liongma/Inverter/Images/20251108220109-IR.jpg

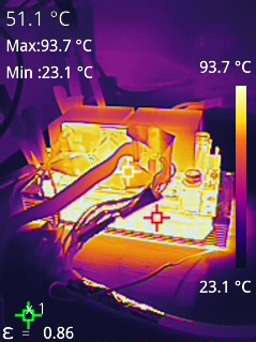
Images/20251108220109-IR.jpg
