liongma/Inverter/Images/banana.jpg

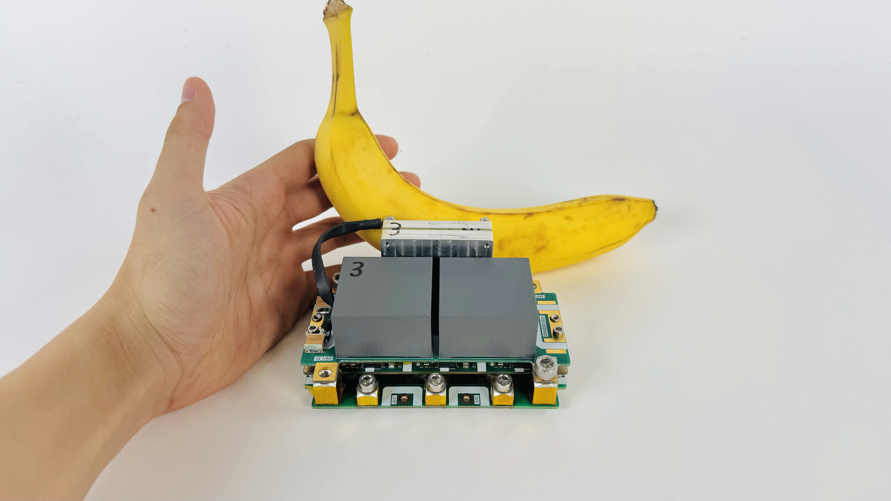
Images/banana.jpg
