liongma/Inverter/Images/box.jpg

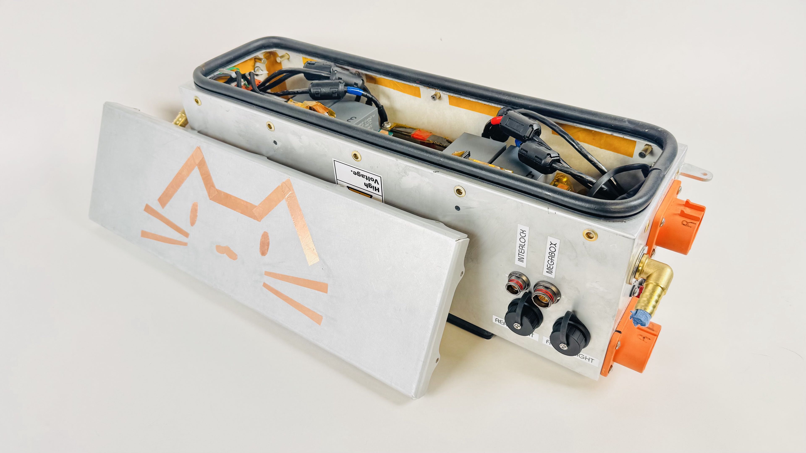
Images/box.jpg
