liongma/Inverter/Images/comparison.jpg

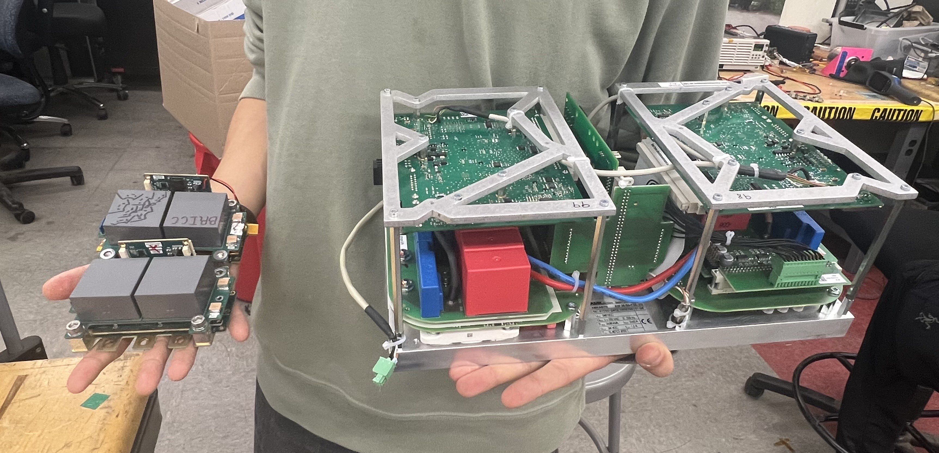
Images/comparison.jpg
