liongma/Inverter/Images/Figure_1.png

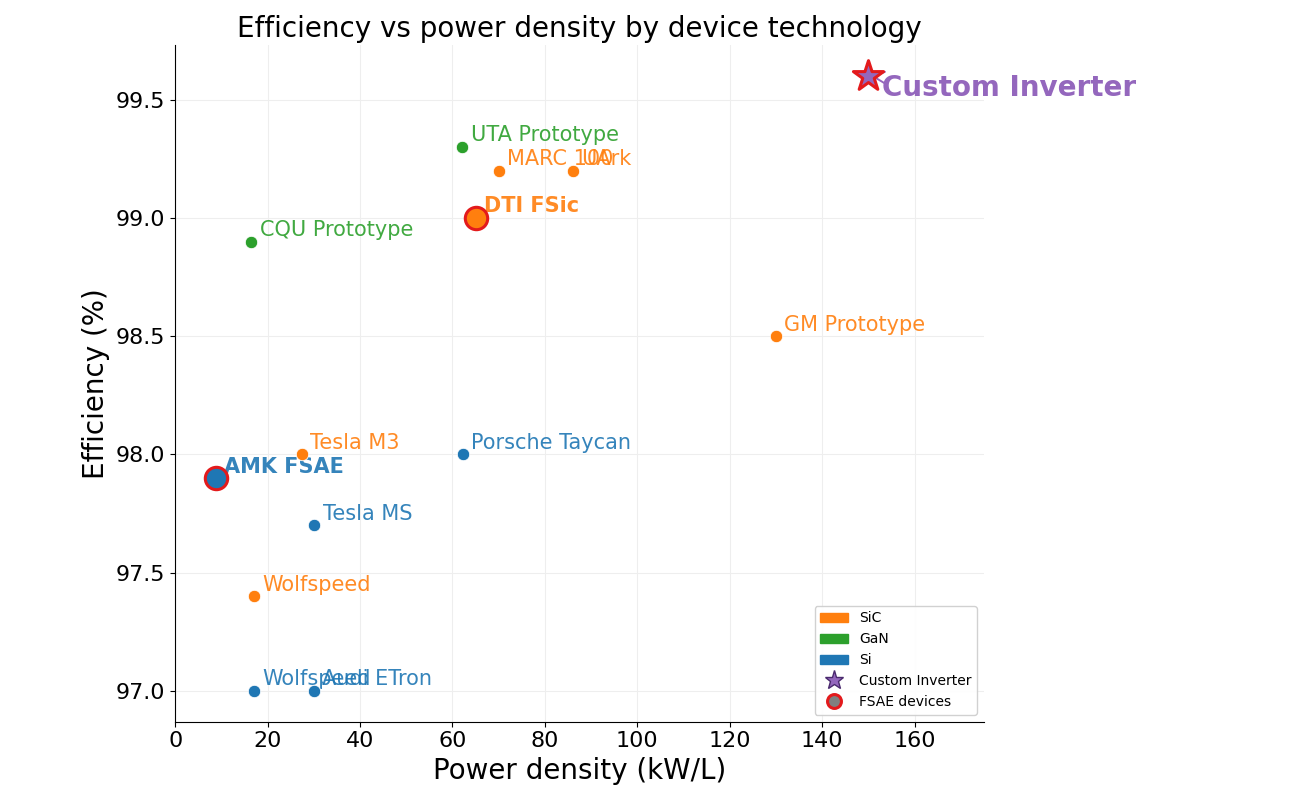
Images/Figure_1.png
