liongma/Inverter/Images/IMG_6918.jpg

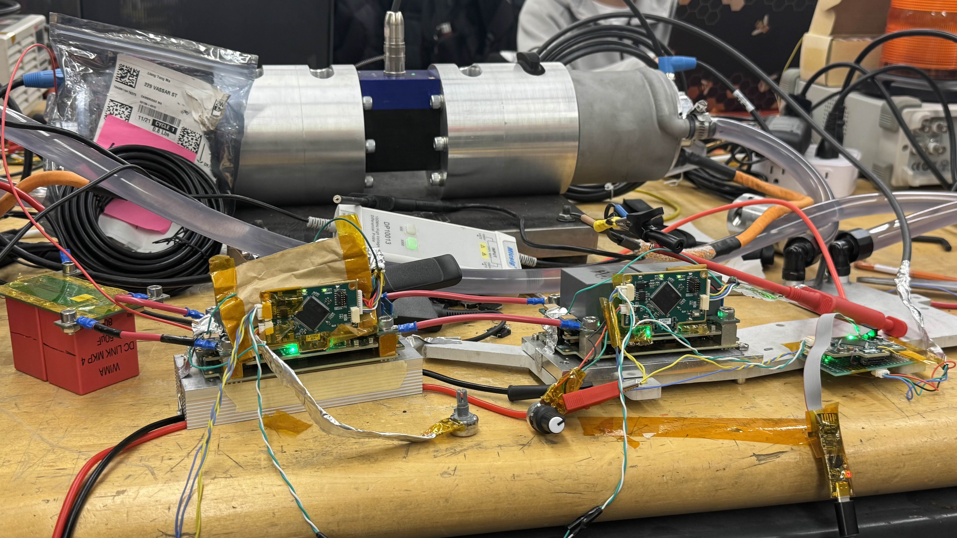
Images/IMG_6918.jpg
