liongma/Inverter/Images/quad.jpg

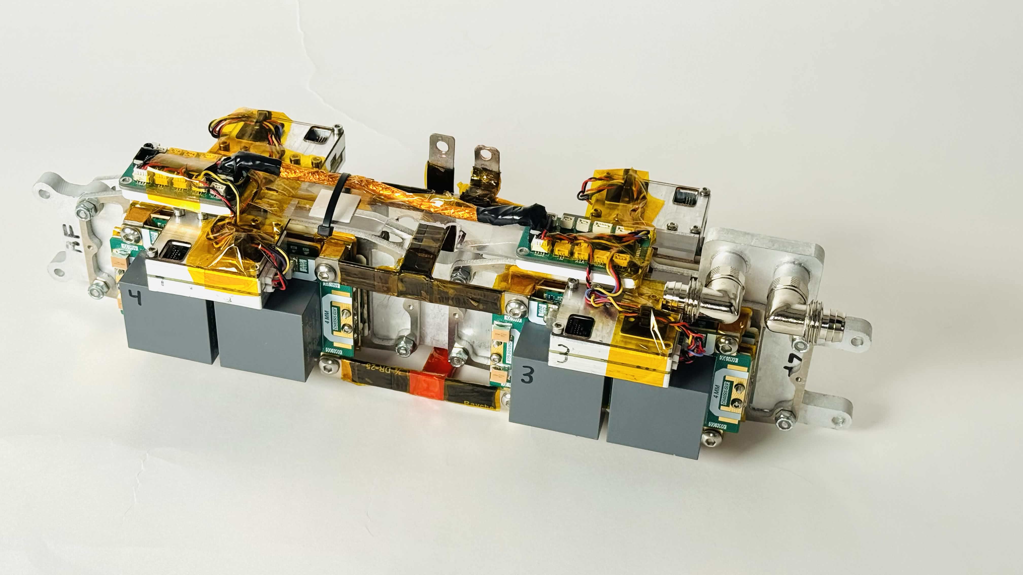
Images/quad.jpg
