liongma/Inverter/Images/Screenshot 2026-03-15 124325.png

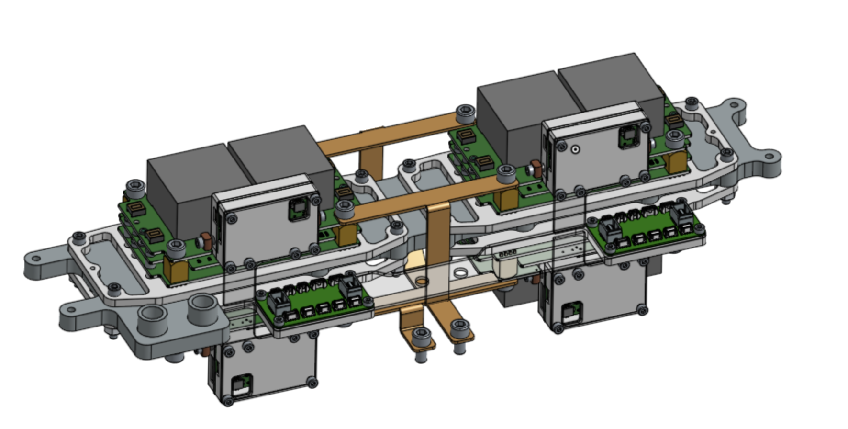
Images/Screenshot 2026-03-15 124325.png
