liongma/Inverter/MY26 Inverter Poster.png

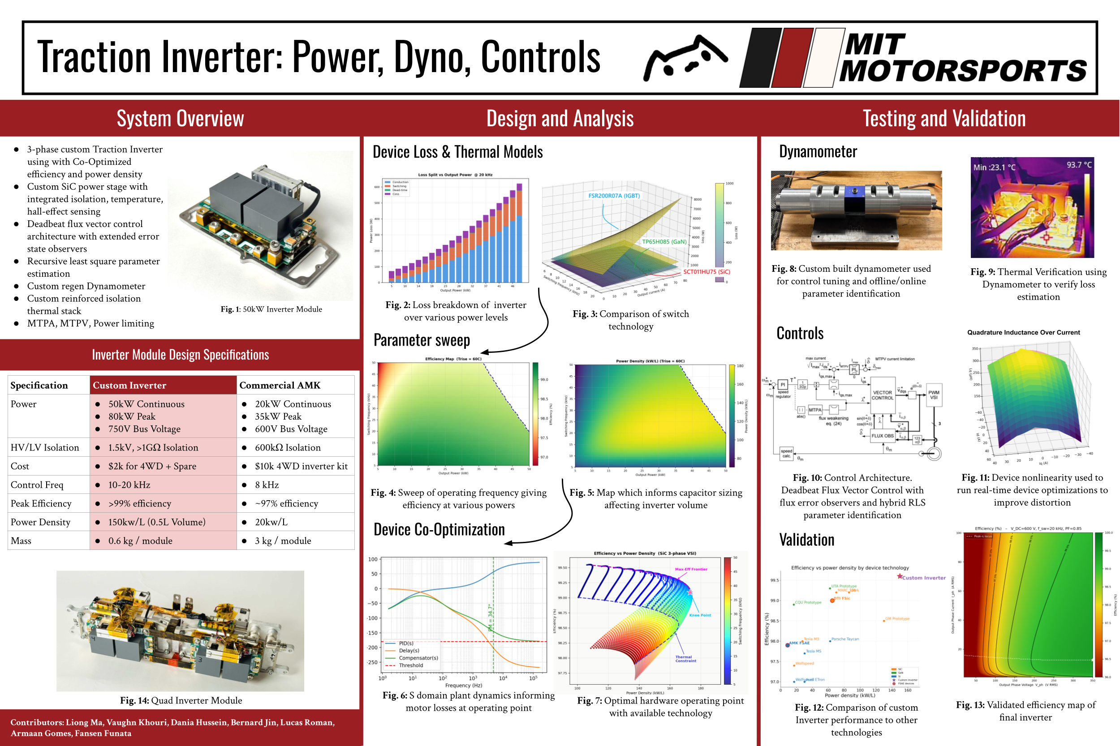
MY26 Inverter Poster.png
