liongma/Inverter/Altium/Compact Inverter DC Link V5/PCB.step

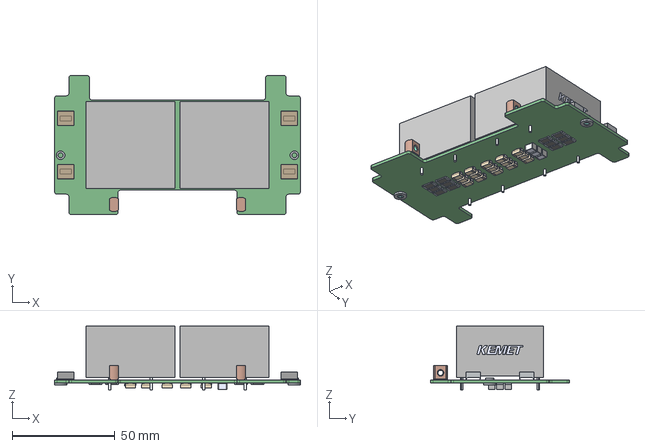
[picture p11: CAD file, 2026-06-16]
Altium/Compact Inverter DC Link V5/PCB.step
120.0 x 68.0 x 31.2 mm
