liongma/Inverter/(list of files, cad)

Other CAD files:
Altium/Compact Inverter Power V5/PCB.DXF
