liongma/Inverter/Images/Inverter_assembly.jpg

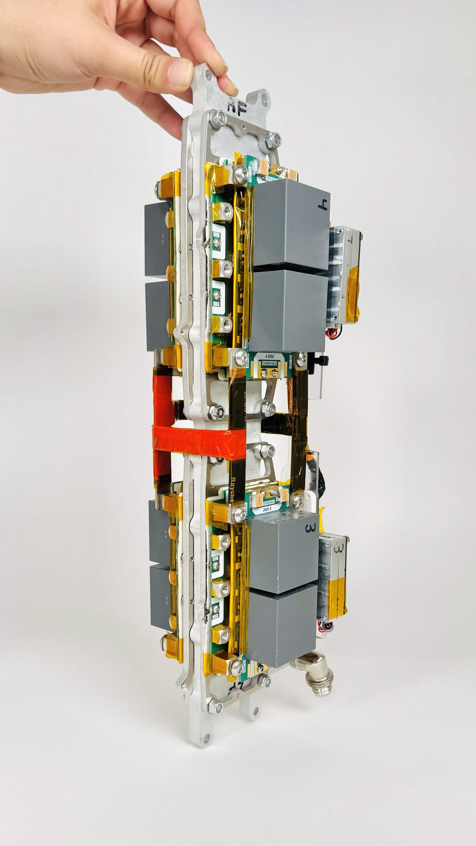
Images/Inverter_assembly.jpg
