liongma/Inverter/(list of files, drawings)

Other design files:
Altium/Compact Inverter DC Link V5/Compact Inverter DC Link V5.PrjPcb
Altium/Compact Inverter DC Link V5/PcbLib3.PcbLib
Altium/Compact Inverter DC Link V5/Schematic.SchDoc
Altium/Compact Inverter DC Link V5/Schlib3.SchLib
Altium/Compact Inverter DC Link V5/Sheet1.SchDoc
Altium/Compact Inverter Driver V5/Bias_High.SchDoc
Altium/Compact Inverter Driver V5/Buck Converter.SchDoc
Altium/Compact Inverter Driver V5/Compact Inverter Driver V5.PrjPcb
Altium/Compact Inverter Driver V5/Driver.SchDoc
Altium/Compact Inverter Driver V5/Gate Connector.SchDoc
Altium/Compact Inverter Driver V5/HallConnector.SchDoc
Altium/Compact Inverter Driver V5/LED.SchDoc
Altium/Compact Inverter Driver V5/Output Connector.SchDoc
Altium/Compact Inverter Driver V5/PcbLib2.PcbLib
Altium/Compact Inverter Driver V5/Schlib2.SchLib
Altium/Compact Inverter Driver V5/Tree.SchDoc
Altium/Compact Inverter Driver V5/Voltage Sensor.SchDoc
Altium/Compact Inverter H7 Logic Ver B/CANBus.SchDoc
Altium/Compact Inverter H7 Logic Ver B/CANConnector.SchDoc
Altium/Compact Inverter H7 Logic Ver B/Compact Inverter H7 Logic Ver B.PrjPcb
Altium/Compact Inverter H7 Logic Ver B/Connector.SchDoc
Altium/Compact Inverter H7 Logic Ver B/EnDat.SchDoc
Altium/Compact Inverter H7 Logic Ver B/MCU.SchDoc
Altium/Compact Inverter H7 Logic Ver B/MotorConnector.SchDoc
Altium/Compact Inverter H7 Logic Ver B/PeripheralConnector.SchDoc
Altium/Compact Inverter H7 Logic Ver B/Power.SchDoc
Altium/Compact Inverter H7 Logic Ver B/PowerConnector.SchDoc
Altium/Compact Inverter H7 Logic Ver B/Schlib1.SchLib
Altium/Compact Inverter H7 Logic Ver B/SDMMC.SchDoc
Altium/Compact Inverter H7 Logic Ver B/Top.SchDoc
Altium/Compact Inverter Power V5/Compact Inverter Power V5.PrjPcb
Altium/Compact Inverter Power V5/Data Connector.SchDoc
Altium/Compact Inverter Power V5/DC Link.SchDoc
Altium/Compact Inverter Power V5/Gate Connect.SchDoc
Altium/Compact Inverter Power V5/HC Standoff.SchDoc
Altium/Compact Inverter Power V5/PcbLib1.PcbLib
Altium/Compact Inverter Power V5/Schlib1.SchLib
Altium/Compact Inverter Power V5/totem.SchDoc
Altium/Compact Inverter Power V5/Tree.SchDoc
Altium/Compact Inverter Power V5/Voltage Divider.SchDoc
Altium/MY26 HV Inverter Logic Board/CANbus.SchDoc
Altium/MY26 HV Inverter Logic Board/CANConnector.SchDoc
Altium/MY26 HV Inverter Logic Board/Connector.SchDoc
Altium/MY26 HV Inverter Logic Board/EnDat.SchDoc
Altium/MY26 HV Inverter Logic Board/EXTADC.SchDoc
Altium/MY26 HV Inverter Logic Board/FaultDet.SchDoc
Altium/MY26 HV Inverter Logic Board/Flash.SchDoc
Altium/MY26 HV Inverter Logic Board/JTAG.SchDoc
Altium/MY26 HV Inverter Logic Board/Main.SchDoc
Altium/MY26 HV Inverter Logic Board/MotorConnector.SchDoc
Altium/MY26 HV Inverter Logic Board/MY26 HV Inverter Logic Board.PrjPcb
Altium/MY26 HV Inverter Logic Board/PeripheralConnector.SchDoc
Altium/MY26 HV Inverter Logic Board/Power.SchDoc
Altium/MY26 HV Inverter Logic Board/PowerConnector.SchDoc
Altium/MY26 HV Inverter Logic Board/Schematic.SchDoc
Altium/MY26 HV Inverter Logic Board/Schlib1.SchLib
Altium/MY26 HV Inverter Logic Board/SDMMC.SchDoc
Altium/MY26 HV Inverter Logic Board/uC.SchDoc
