liongma/Inverter/Code/InverterH7/Firmware/InverterH7/Core/Src/main.c

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
/* Includes ------------------------------------------------------------------*/
#include "main.h"
#include "fatfs.h"

/* USER CODE BEGIN Includes */
#include <string.h>
#include <stdio.h>

#include "adc.h"
#include "hall.h"
#include "encoder.h"
#include "main.h"
#include "appMath.h"
#include "sdcard.h"
/* USER CODE END Includes */

/* USER CODE BEGIN PD */
#define UPHASE TIM1->CCR1
#define VPHASE TIM1->CCR2
#define WPHASE TIM1->CCR3
#define ENABLE_OUT HAL_GPIO_WritePin(GPIOE, GPIO_PIN_14, 1)
#define DISABLE_OUT HAL_GPIO_WritePin(GPIOE, GPIO_PIN_14, 0)

#define PWM_MAX 8000

/* USER CODE END PD */

/* USER CODE BEGIN PM */
#define V2PWM 8192.0/v_bus
/* USER CODE END PM */

ADC_HandleTypeDef hadc1;
ADC_HandleTypeDef hadc3;
DMA_HandleTypeDef hdma_adc1;

CORDIC_HandleTypeDef hcordic;

FDCAN_HandleTypeDef hfdcan1;

I2C_HandleTypeDef hi2c1;

SD_HandleTypeDef hsd1;

SPI_HandleTypeDef hspi1;
SPI_HandleTypeDef hspi2;

TIM_HandleTypeDef htim1;
TIM_HandleTypeDef htim2;
TIM_HandleTypeDef htim16;

UART_HandleTypeDef huart1;
DMA_HandleTypeDef hdma_usart1_tx;

/* USER CODE BEGIN PV */
char msg[100] = {};

uint16_t iu = 0;
uint16_t iv = 0;
uint16_t iw = 0;


uint32_t motor = 0;

uint16_t hallOffset[3] = {0};
uint16_t hallValue[3] = {0};

uint32_t adcOffset[10] = {0};
uint32_t adcValue[10] = {0};

volatile float i_phase[3] = {0};
volatile uint32_t tI = 0;
volatile float freq = 0;
volatile float theta = 0;
volatile float thetaI = 0;
volatile float omega = 0;

volatile float v_bus = 0;

float theta_e = 0;
float omega_e = 0;

DQ_Components integral = {0,0};
DQ_Components error = {0,0};

volatile DQ_Components ref = {.d = 0 , .q = 0};

/* USER CODE END PV */

void SystemClock_Config(void);
void PeriphCommonClock_Config(void);
static void MPU_Config(void);
static void MX_GPIO_Init(void);
static void MX_DMA_Init(void);
static void MX_ADC1_Init(void);
static void MX_ADC3_Init(void);
static void MX_CORDIC_Init(void);
static void MX_FDCAN1_Init(void);
static void MX_I2C1_Init(void);
static void MX_SPI1_Init(void);
static void MX_SPI2_Init(void);
static void MX_TIM1_Init(void);
static void MX_TIM16_Init(void);
static void MX_USART1_UART_Init(void);
static void MX_TIM2_Init(void);
static void MX_SDMMC1_SD_Init(void);
/**
  * @brief  The application entry point.
  * @retval int
  */
int main(void)
{

  /* MPU Configuration--------------------------------------------------------*/
  MPU_Config();

  /* MCU Configuration--------------------------------------------------------*/

  /* Reset of all peripherals, Initializes the Flash interface and the Systick. */
  HAL_Init();

  /* Configure the system clock */
  SystemClock_Config();

  /* Configure the peripherals common clocks */
  PeriphCommonClock_Config();

  /* Initialize all configured peripherals */
  MX_GPIO_Init();
  MX_DMA_Init();
  MX_ADC1_Init();
  MX_ADC3_Init();
  MX_CORDIC_Init();
  MX_FDCAN1_Init();
  MX_I2C1_Init();
  MX_SPI1_Init();
  MX_SPI2_Init();
  MX_TIM1_Init();
  MX_TIM16_Init();
  MX_USART1_UART_Init();
  MX_TIM2_Init();
  MX_SDMMC1_SD_Init();
  MX_FATFS_Init();
  /* USER CODE BEGIN 2 */

  HAL_TIM_Base_Start(&htim16);

  ENABLE_OUT;
  HAL_TIM_PWM_Start(&htim1, TIM_CHANNEL_1);
  HAL_TIMEx_PWMN_Start(&htim1, TIM_CHANNEL_1);
  UPHASE = 0;
  HAL_TIM_PWM_Start(&htim1, TIM_CHANNEL_2);
  HAL_TIMEx_PWMN_Start(&htim1, TIM_CHANNEL_2);
  VPHASE = 0;
  HAL_TIM_PWM_Start(&htim1, TIM_CHANNEL_3);
  HAL_TIMEx_PWMN_Start(&htim1, TIM_CHANNEL_3);
  WPHASE = 0;

  HAL_ADC_Start_DMA(&hadc1, adcValue, 2);

  callibrateHall(&hspi2,hallOffset);
  callibrateADC(&hadc1,adcOffset);



  /* USER CODE END 2 */

  /* Infinite loop */
  /* USER CODE BEGIN WHILE */

  uint32_t printCounter =0;
  float	fake_angle = 0;
  float angle_offset = 0;
//  float angle_offset = 2.7 + M_PI2;
//  float angle_offset = 1.032;
//  float angle_offset = 0.06790161132;
//  	float angle_offset = 4.4;
//  float angle_offset = -2.25;

//  float angle_offset = 2.05 - M_2PI/3;
//		UPHASE = 300;
//		HAL_Delay(1000);
//  	  readEncoder(&motor);
//	theta = motor*ENDAT2RAD;
//	theta_e = normalizeAngle(theta*5);
//	sprintf(msg, "%f",theta_e);
//	HAL_UART_Transmit_DMA(&huart1, (uint8_t*)msg, strlen(msg));

//  float angle_offset = M_PI2;
////  SDIO_SDCard_Test();
  while (1)
  {




	uint32_t dt = __HAL_TIM_GET_COUNTER(&htim16) - tI;
	tI = __HAL_TIM_GET_COUNTER(&htim16);
	freq = (1000000.0/(float)dt);
	readEncoder(&motor);
	theta = normalizeAngle((motor)*ENDAT2RAD);
//	if(theta == 0 || theta == 65536){
//		theta = thetaI;
//	}
	omega = shortenAngle(theta - thetaI)*(freq);
	thetaI = theta;

	//electrical equivalent
	theta_e = normalizeAngle((theta) * 5);
	fake_angle = normalizeAngle(fake_angle + 0.0003);
//	theta_e = fake_angle;
	omega_e = omega * 5;

//	angle_offset = normalizeAngle(angle_offset + 0.00003);

	float real_angle = normalizeAngle(theta * 5);

//	angle_offset= (float)(((float)adcValue[1]-500)/10000);

	theta_e = normalizeAngle(theta_e);

	pollCurrent(&hspi2, i_phase, hallValue, hallOffset);
	pollVoltage(&hadc1, &v_bus, adcValue, adcOffset);

	AlphaBeta_Components i_alpha_beta = clarkeTransform(i_phase[2], i_phase[0], i_phase[1]);
	DQ_Components i_dq = parkTransform(i_alpha_beta.alpha, i_alpha_beta.beta, theta_e);

//		i_dq.d = 0;
//		i_d/q.q = 0;

	//volatile DQ_Components dec = {.d = 0.05 , .q = 0.05};
//	volatile DQ_Components Kp = {.d = 0.46, .q = 0.53}; // V/A
	float Lq = 0.000240f; //uH
	float Ld = 0.000120f; //uH
	float R = 0.135f; //R
	float w = 266.0f;
	volatile DQ_Components Kp = {.d = 3, .q = 3}; // V/A
	volatile DQ_Components Ki = {.d = 0, .q = 0}; // V/A

	    // 5. PI control
	ref.d = 0;
	ref.q = 10;
	ref.q = (float)((adcValue[1]-500)/800);

	error.d = (ref.d - i_dq.d);
	error.q = (ref.q - i_dq.q);

	integral.d += error.d * 0.0001f * Ki.d;
	integral.q += error.q * 0.0001f * Ki.q;

	float integral_limit = 10;
	if(integral.d > integral_limit) integral.d = integral_limit;
	if(integral.d < -integral_limit) integral.d = -integral_limit;

	if(integral.q > integral_limit) integral.q = integral_limit;
	if(integral.q < -integral_limit) integral.q= -integral_limit;







////	float flux_linkage = 0.26f; // v/(rad/s)
	float flux_linkage = 0.05319148936f;
//	flux_linkage = 0;
//	omega_e = 0;
	float vd = Kp.d * error.d + integral.d;// + omega_e * Lq*i_dq.q;
	float vq = Kp.q * error.q + integral.q;// - omega_e *(Ld*i_dq.d + flux_linkage); //+,-

//	vd = 0;
//	vq = 3;

//	float vd = Kp.d * error.d + Ki.d * integral.d;
//	float vq = Kp.q * error.q + Ki.q * integral.q;
	// 6. Inverse Park (dq -> αβ)

	AlphaBeta_Components v_alpha_beta = inverseParkTransform(vd, vq, theta_e);

	// 7. Inverse Clarke (αβ -> UVW)
	ThreePhase_Components v_uvw = inverseClarkeTransform(v_alpha_beta.alpha, v_alpha_beta.beta);

	// 8. Scale and output to PWM

	v_uvw.a += v_bus/2;
	v_uvw.b += v_bus/2;
	v_uvw.c += v_bus/2;


	WPHASE = (int)(fmaxf(0, fminf(PWM_MAX, (v_uvw.a*V2PWM))));
	UPHASE = (int)(fmaxf(0, fminf(PWM_MAX, (v_uvw.b*V2PWM))));
	VPHASE = (int)(fmaxf(0, fminf(PWM_MAX, (v_uvw.c*V2PWM))));

	if(printCounter++ > 500){
		printCounter = 0;
//		sprintf(msg,"%lu, %lu, %lu, %lu",motor,UPHASE,VPHASE,WPHASE);
//		sprintf(msg,"%lu, %f, %f, %f \n",motor,v_uvw.a,v_uvw.b,v_uvw.c);
//		sprintf(msg,"%f, %f",i_dq.d,i_dq.q);
//		sprintf(msg,"%lu, %f, %f, %f \n",motor,i_phase[0],i_phase[1],i_phase[2]);
//		sprintf(msg,"%lu, %d, %d, %d, %d \n",motor,hallOffset[0],hallOffset[1],hallOffset[2],adcOffset[0]);

//		sprintf(msg,"angle:%2.2f, offset:%+2.2f, ia:%+2.1f, ib:%+2.1f, ic:%+2.1f, v1:%+2.1f, v2:%+2.1f, v3:%+2.1f"
//					,theta_e,	angle_offset,	i_phase[0],i_phase[1],i_phase[2],v_uvw.a, v_uvw.b ,v_uvw.c);
		sprintf(msg,"angle:%2.2f, offset:%2.2f, cmdq: %2.1f, iq:%+2.1f, id:%+2.1f, vq:%+2.1f, vd:%+3.1f, v:%2.1f, omega:%2.2f\n"
					,real_angle	,angle_offset,		ref.q, 		i_dq.q, 	i_dq.d, 	vq,		 vd, 	v_bus, omega_e);
//		sprintf(msg,"%lu \n",adcValue[1]);
//		float diff = theta_e - real_angle;
//		sprintf(msg, "fake:%f, real:%f, offset:%f \n",theta_e,real_angle,diff);
//		sprintf(msg,"r:%f off:%f omega:%f\n",theta_e,angle_offset,omega_e);

//		sprintf(msg, "%d %d %d",UPHASE,VPHASE,WPHASE);
		HAL_UART_Transmit_DMA(&huart1, (uint8_t*)msg, strlen(msg));
	}

	HAL_GPIO_WritePin(LED1_GPIO_Port, LED1_Pin, 1);
	HAL_GPIO_WritePin(LED2_GPIO_Port, LED2_Pin, 1);



    /* USER CODE END WHILE */

    /* USER CODE BEGIN 3 */
  }
  /* USER CODE END 3 */
}

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
 /* MPU Configuration */

void MPU_Config(void)
{
  MPU_Region_InitTypeDef MPU_InitStruct = {0};

  /* Disables the MPU */
  HAL_MPU_Disable();

  /** Initializes and configures the Region and the memory to be protected
  */
  MPU_InitStruct.Enable = MPU_REGION_ENABLE;
  MPU_InitStruct.Number = MPU_REGION_NUMBER0;
  MPU_InitStruct.BaseAddress = 0x0;
  MPU_InitStruct.Size = MPU_REGION_SIZE_4GB;
  MPU_InitStruct.SubRegionDisable = 0x87;
  MPU_InitStruct.TypeExtField = MPU_TEX_LEVEL0;
  MPU_InitStruct.AccessPermission = MPU_REGION_NO_ACCESS;
  MPU_InitStruct.DisableExec = MPU_INSTRUCTION_ACCESS_DISABLE;
  MPU_InitStruct.IsShareable = MPU_ACCESS_SHAREABLE;
  MPU_InitStruct.IsCacheable = MPU_ACCESS_NOT_CACHEABLE;
  MPU_InitStruct.IsBufferable = MPU_ACCESS_NOT_BUFFERABLE;

  HAL_MPU_ConfigRegion(&MPU_InitStruct);
  /* Enables the MPU */
  HAL_MPU_Enable(MPU_PRIVILEGED_DEFAULT);

}

/**
  * @brief  This function is executed in case of error occurrence.
  * @retval None
  */
void Error_Handler(void)
{
  /* USER CODE BEGIN Error_Handler_Debug */
  /* User can add his own implementation to report the HAL error return state */
  __disable_irq();
  while (1)
  {
  }
  /* USER CODE END Error_Handler_Debug */
}
#ifdef USE_FULL_ASSERT
/**
  * @brief  Reports the name of the source file and the source line number
  *         where the assert_param error has occurred.
  * @param  file: pointer to the source file name
  * @param  line: assert_param error line source number
  * @retval None
  */
void assert_failed(uint8_t *file, uint32_t line)
{
  /* USER CODE BEGIN 6 */
  /* User can add his own implementation to report the file name and line number,
     ex: printf("Wrong parameters value: file %s on line %d\r\n", file, line) */
  /* USER CODE END 6 */
}
#endif /* USE_FULL_ASSERT */
