liongma/Inverter/Code/InverterH7/Firmware/InverterH7/Inverter H7.ioc

Mcu.UserName=STM32H723VGTx
PA1.Signal=ADC1_INP17
PA10.Signal=USART1_RX
PA13(JTMS/SWDIO).Signal=DEBUG_JTMS-SWDIO
PA14(JTCK/SWCLK).Signal=DEBUG_JTCK-SWCLK
PA15(JTDI).GPIO_Label=RGB
PA15(JTDI).Signal=S_TIM2_CH1_ETR
PA2.Signal=ADCx_INP14
PA3.Signal=ADCx_INP15
PA4.GPIO_Label=EN_DAT
PA4.Signal=GPIO_Output
PA5.Signal=SPI1_SCK
PA6.Signal=SPI1_MISO
PA7.Signal=SPI1_MOSI
PA9.Signal=USART1_TX
PB0.GPIO_Label=U_OC
PB0.Signal=GPIO_Input
PB1.GPIO_Label=V_OC
PB1.Signal=GPIO_Input
PB13.Signal=SPI2_SCK
PB14.Signal=SPI2_MISO
PB2.GPIO_Label=W_OC
PB2.Signal=GPIO_Input
PB3(JTDO/TRACESWO).Signal=DEBUG_JTDO-SWO
PB6.Signal=I2C1_SCL
PB7.Signal=I2C1_SDA
PB8.Signal=FDCAN1_RX
PB9.Signal=FDCAN1_TX
PC0.Signal=ADCx_INP10
PC1.Signal=ADCx_INP11
PC10.Signal=SDMMC1_D2
PC11.Signal=SDMMC1_D3
PC12.Signal=SDMMC1_CK
PC2_C.Signal=ADC3_INP0
PC3_C.Signal=ADC3_INP1
PC4.Signal=ADCx_INP4
PC5.Signal=ADCx_INN4
PC8.Signal=SDMMC1_D0
PC9.Signal=SDMMC1_D1
PD0.GPIO_Label=SD_DETECT
PD0.Signal=GPIO_Input
PD10.GPIO_Label=W_HALL_CS
PD10.Signal=GPIO_Output
PD2.Signal=SDMMC1_CMD
PD8.GPIO_Label=U_HALL_CS
PD8.Signal=GPIO_Output
PD9.GPIO_Label=V_HALL_CS
PD9.Signal=GPIO_Output
PE1.GPIO_Label=FAULT
PE1.Signal=GPIO_Input
PE10.Signal=TIM1_CH2N
PE11.Signal=S_TIM1_CH2
PE12.Signal=TIM1_CH3N
PE13.Signal=S_TIM1_CH3
PE14.GPIO_Label=OE
PE14.Signal=GPIO_Output
PE2.GPIO_Label=LED1
PE2.Signal=GPIO_Output
PE3.GPIO_Label=LED2
PE3.Signal=GPIO_Output
PE8.Signal=TIM1_CH1N
PE9.Signal=S_TIM1_CH1
PH0-OSC_IN.Signal=RCC_OSC_IN
PH1-OSC_OUT.Signal=RCC_OSC_OUT
