liongma/Inverter/Code/InverterH7/Firmware/H7Rev2/Core/Inc/main.h

#define V2PWM PWM_MAX/v_bus
#define LED1_Pin GPIO_PIN_2
#define LED1_GPIO_Port GPIOE
#define LED2_Pin GPIO_PIN_3
#define LED2_GPIO_Port GPIOE
#define VSENSE__Pin GPIO_PIN_0
#define VSENSE__GPIO_Port GPIOC
#define VSENSE_C1_Pin GPIO_PIN_1
#define VSENSE_C1_GPIO_Port GPIOC
#define IU__Pin GPIO_PIN_0
#define IU__GPIO_Port GPIOA
#define IU_A1_Pin GPIO_PIN_1
#define IU_A1_GPIO_Port GPIOA
#define IV__Pin GPIO_PIN_4
#define IV__GPIO_Port GPIOC
#define IV_C5_Pin GPIO_PIN_5
#define IV_C5_GPIO_Port GPIOC
#define IW__Pin GPIO_PIN_0
#define IW__GPIO_Port GPIOB
#define IW_B1_Pin GPIO_PIN_1
#define IW_B1_GPIO_Port GPIOB
#define EN_DAT_Pin GPIO_PIN_2
#define EN_DAT_GPIO_Port GPIOB
#define OE_Pin GPIO_PIN_14
#define OE_GPIO_Port GPIOE
#define PROBE_Pin GPIO_PIN_13
#define PROBE_GPIO_Port GPIOB
#define U_HALL_CS_Pin GPIO_PIN_8
#define U_HALL_CS_GPIO_Port GPIOD
#define V_HALL_CS_Pin GPIO_PIN_9
#define V_HALL_CS_GPIO_Port GPIOD
#define W_HALL_CS_Pin GPIO_PIN_10
#define W_HALL_CS_GPIO_Port GPIOD
#define RGB_Pin GPIO_PIN_15
#define RGB_GPIO_Port GPIOA
#define SD_DETECT_Pin GPIO_PIN_0
#define SD_DETECT_GPIO_Port GPIOD
#define FAULT_Pin GPIO_PIN_1
#define FAULT_GPIO_Port GPIOE
#define UPHASE TIM1->CCR1
#define VPHASE TIM1->CCR2
#define WPHASE TIM1->CCR3
#define ENABLE_OUT LL_GPIO_SetOutputPin(GPIOE, GPIO_PIN_14);
#define DISABLE_OUT LL_GPIO_ResetOutputPin(GPIOE, GPIO_PIN_14);
#define IDLE_OUT TIM1->BDTR &= ~TIM_BDTR_MOE;
#define ACTIVE_OUT TIM1->BDTR |= TIM_BDTR_MOE;
