liongma/Inverter/Code/InverterH7/Firmware/H7Rev2/Core/Src/lut.c

/*
 * lut.c
 *
 *  Created on: Dec 10, 2025
 *      Author: lionm
 */


#include "lut.h"

const uint8_t iwv[21][21][14] = {
		  {
		    {251, 11, 10, 0, 0, 0, 0, 0, 0, 0, 11, 0, 0, 0},
		    {251, 251, 251, 251, 251, 251, 251, 251, 251, 251, 251, 251, 251, 251},
		    {251, 251, 251, 251, 251, 251, 251, 251, 251, 251, 251, 251, 251, 251},
		    {251, 251, 251, 251, 251, 251, 251, 251, 251, 251, 251, 251, 251, 251},
		    {251, 251, 251, 251, 251, 251, 251, 251, 251, 251, 251, 251, 251, 251},
		    {251, 251, 251, 251, 251, 251, 251, 251, 251, 251, 251, 251, 251, 251},
		    {251, 251, 251, 251, 251, 251, 251, 251, 251, 251, 251, 251, 251, 251},
		    {251, 251, 251, 251, 251, 251, 251, 251, 251, 251, 251, 251, 251, 251},
		    {251, 251, 251, 251, 251, 251, 251, 251, 251, 251, 251, 251, 251, 251},
		    {251, 251, 251, 251, 251, 251, 251, 251, 251, 251, 251, 251, 251, 251},
		    {251, 251, 251, 251, 251, 251, 251, 251, 251, 251, 251, 251, 251, 251},
		    {251, 251, 251, 251, 251, 251, 251, 251, 251, 251, 251, 251, 251, 251},
		    {251, 251, 251, 251, 251, 251, 251, 251, 251, 251, 251, 251, 251, 251},
		    {251, 251, 251, 251, 251, 251, 251, 251, 251, 251, 251, 251, 251, 251},
		    {251, 251, 251, 251, 251, 251, 251, 251, 251, 251, 251, 251, 251, 251},
		    {251, 251, 251, 251, 251, 251, 251, 251, 251, 251, 251, 251, 251, 251},
		    {251, 251, 251, 251, 251, 251, 251, 251, 251, 251, 251, 251, 251, 251},
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
		    {251, 251, 251, 251, 251, 251, 251, 251, 251, 231, 186, 140, 140, 140},
		    {251, 251, 251, 251, 251, 251, 251, 251, 251, 251, 220, 177, 140, 140},
		    {251, 251, 251, 251, 251, 251, 251, 251, 251, 251, 247, 210, 169, 140},
		    {251, 251, 251, 251, 251, 251, 251, 251, 251, 251, 251, 236, 201, 162},
		    {251, 251, 251, 251, 251, 251, 251, 251, 251, 251, 251, 251, 227, 193},
		    {251, 251, 251, 251, 251, 251, 251, 251, 251, 251, 251, 251, 248, 218},
		    {251, 251, 251, 251, 251, 251, 251, 251, 251, 251, 251, 251, 251, 239},
		    {251, 251, 251, 251, 251, 251, 251, 251, 251, 251, 251, 251, 251, 251},
		    {251, 251, 251, 251, 251, 251, 251, 251, 251, 251, 251, 251, 251, 251},
		  }
		};
