liongma/Inverter/Code/InverterH7/Firmware/H7Rev2/Core/Inc/off_detect.h

/*
 * off_detect.h
 *
 *  Created on: Mar 1, 2026
 *      Author: lionm
 */

#ifndef INC_OFF_DETECT_H_
#define INC_OFF_DETECT_H_

#include "main.h"
#include "defines.h"

extern float omega_inj;
extern float t_inj;
extern float sin_inj;
extern float cos_inj;
extern float amp_inj;



void run_detect();

#endif /* INC_OFF_DETECT_H_ */
