liongma/Inverter/Code/InverterH7/Firmware/H7Rev2/Core/Inc/off_param.h

/*
 * off_param.h
 *
 *  Created on: Jan 21, 2026
 *      Author: lionm
 */

#ifndef INC_OFF_PARAM_H_
#define INC_OFF_PARAM_H_

float estimate_Lq(float Iq, float Id);
float estimate_Ld(float Iq, float Id);

#endif /* INC_OFF_PARAM_H_ */
