liongma/Inverter/Code/InverterH7/Firmware/InverterH7/Core/Inc/sdcard.h

/*
 * sd.h
 *
 *  Created on: Aug 14, 2025
 *      Author: LiongMa
 */

#ifndef INC_SDCARD_H_
#define INC_SDCARD_H_

#include "main.h"
#include <stdio.h>
#include <string.h>
#include "fatfs.h"

void SDIO_SDCard_Test(void);

#endif /* INC_SDCARD_H_ */
